Sahas9923/aquahyel-water-Hyacinth-Remover-Robot-/project-presentation.pdf

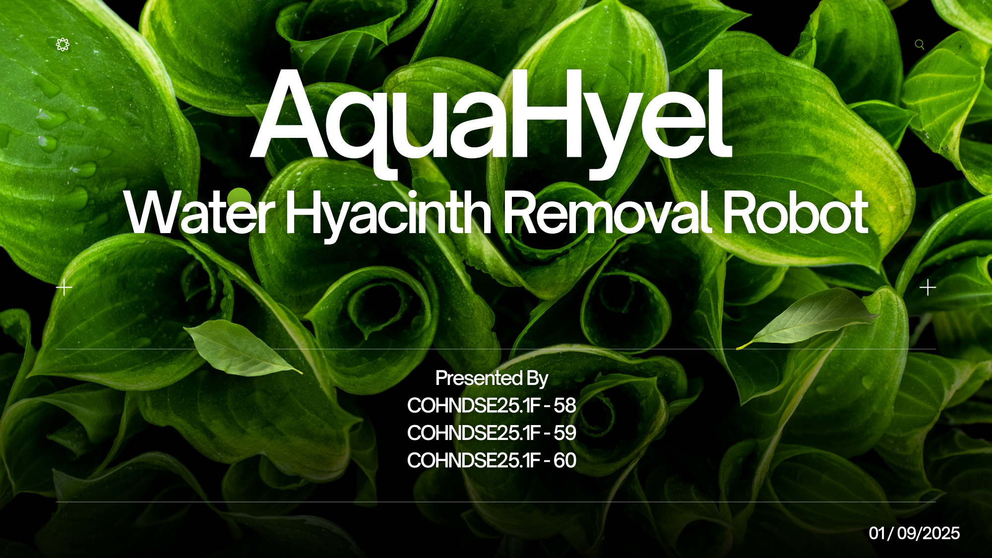
[picture p9: page 1]

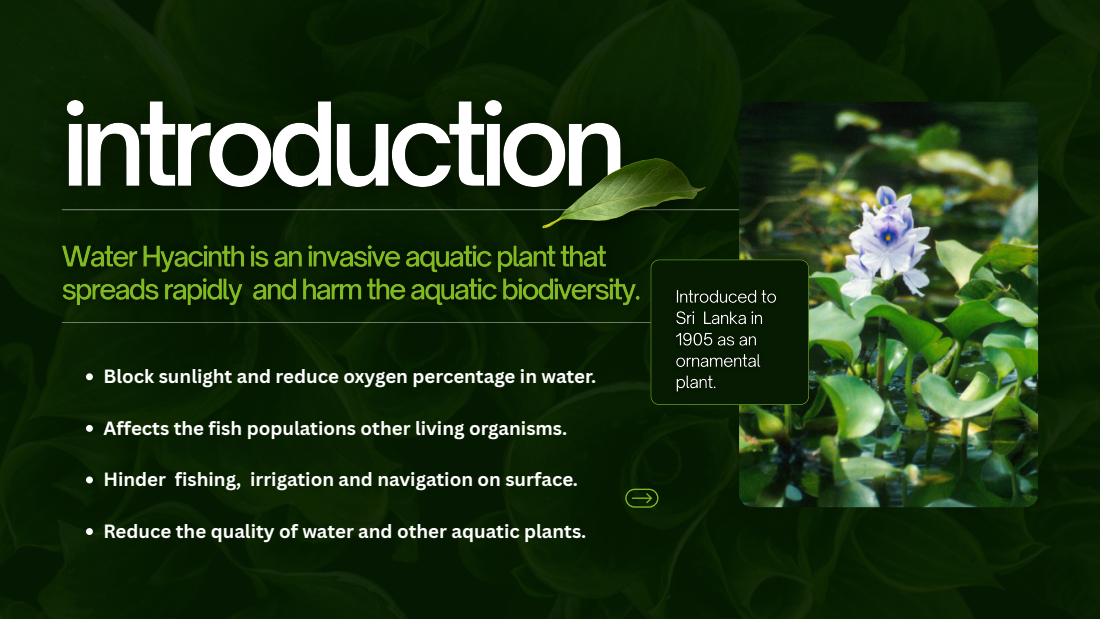
[picture p10: page 2]

Block sunlight and reduce oxygen percentage in water.

Affects the fish populations other living organisms.

Hinder fishing, irrigation and navigation on surface.

Reduce the quality of water and other aquatic plants.

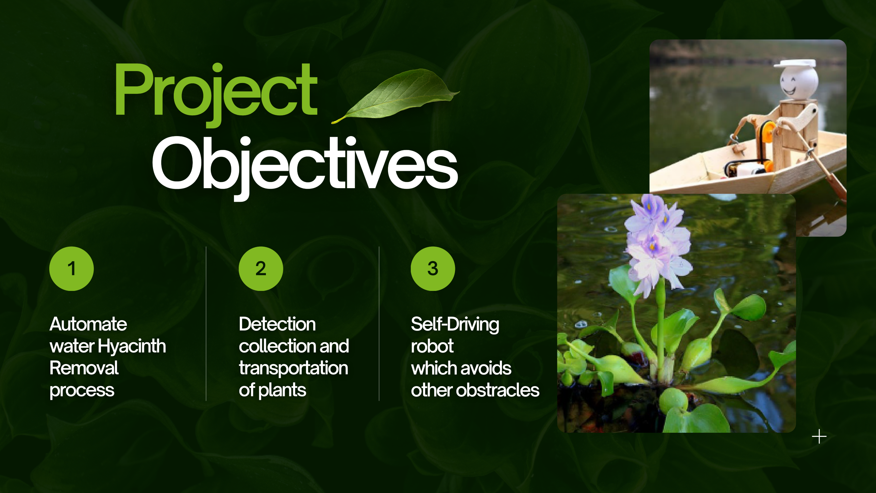
[picture p11: page 3]

1 | 2 | 3

P

R

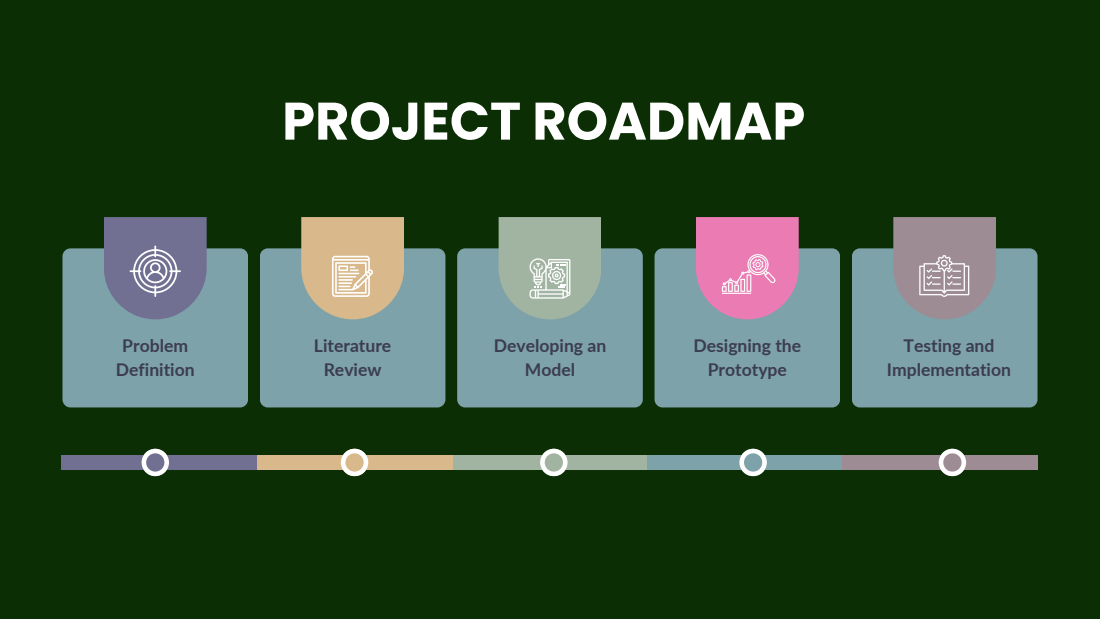
[picture p12: page 4]
ble; elo; ple

# 1 Arduino UNO

# Gear Motors ²

# 4 Motor Driver

# 3 Relay Module

# 5 Servo Motor

# Components Review

# Buck Converters

5
6

# 7 Ultrasonic Sensor Module

# Push Buttons ⁸

# 10 LCD Display

# 9 Load Cell Module

# 11 Buzzer & LED Bulb

# Breadboard

5
12

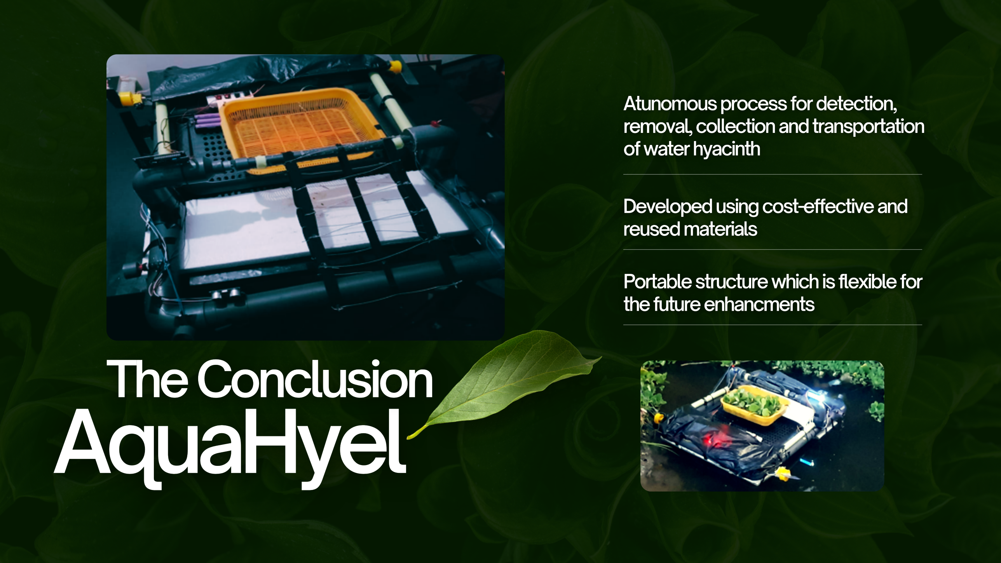
[picture p13: page 6]

# Thank You!

Q & A
